danishsajjad/Headphone-Amplifier-2.0/README.md

# Headphone-Amplifier-2.0
 Attempt to create a headphone amplifier.
