danishsajjad/Headphone-Amplifier-2.0/Docs/Hand Written Design.pdf

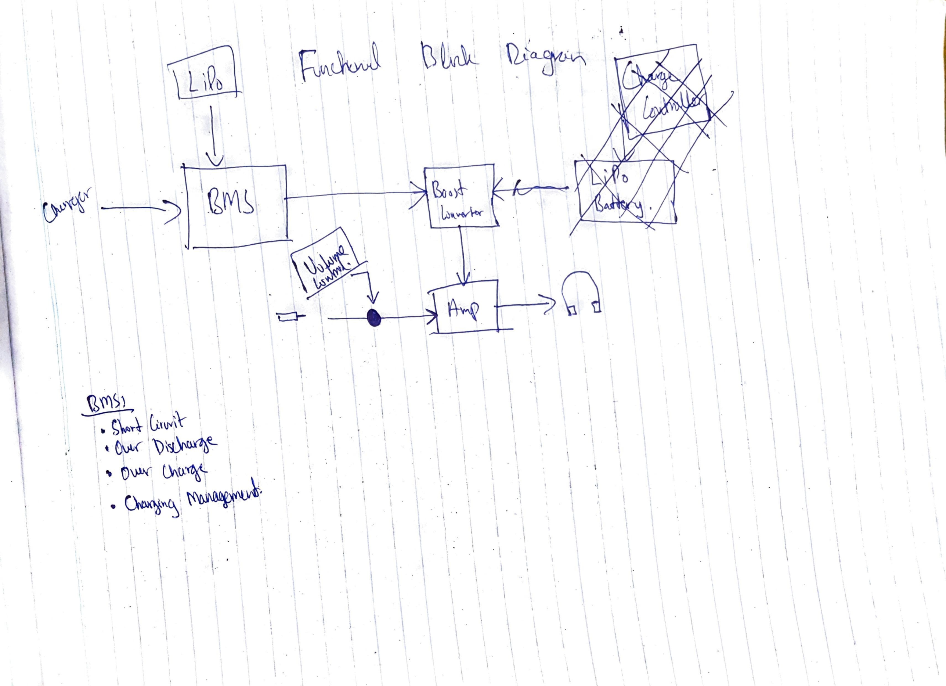
[picture p3: page 1]

# uil

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
'---

~--

~~6)~ ~~~

I.
.I

I j.
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
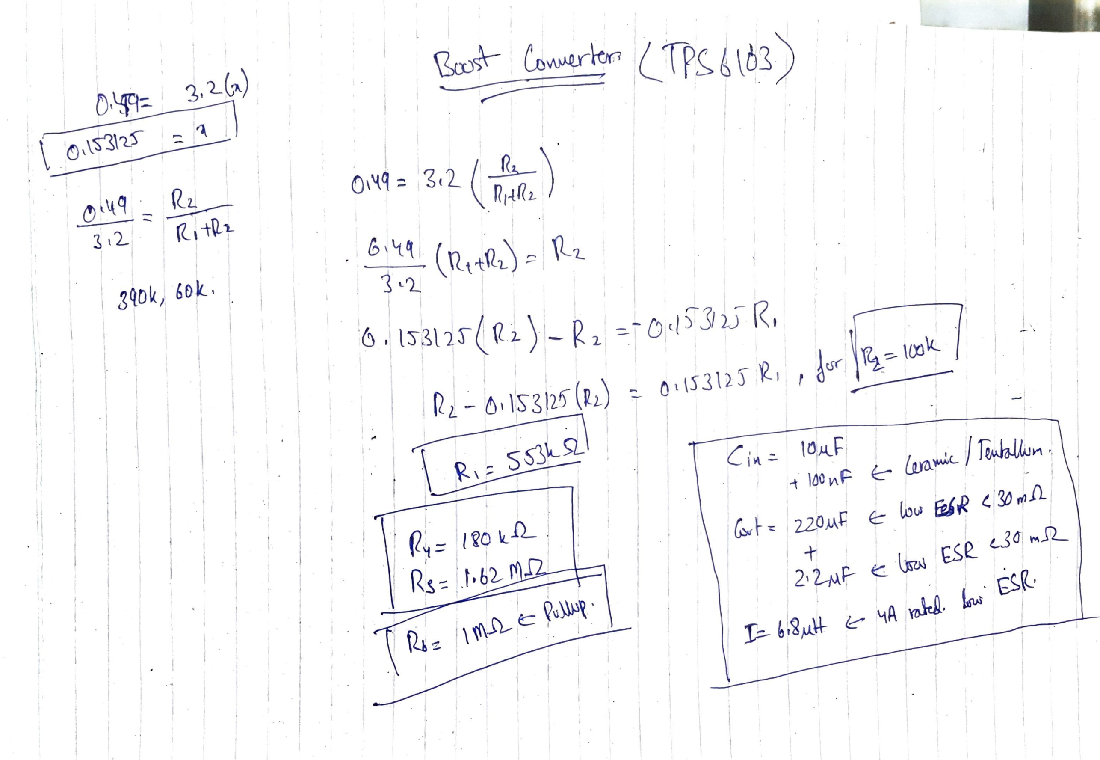
[picture p4: page 2]

## /').\fl::- 3 · '2.. C.._)

\ . C),\~\'l_-S- '.'- 'l,

I .
~ l
I
I

1,

, 3~ok1 60~. .

I I I

I ,

I I I

I

# i I . I

I •
' ' I I • • I
l I
I .
I

()11\9 :: ~( 2. / __&,._ \
\ R1-iR2- )

### . G,¼.~ , . 1 ,')__ ( ll, 1:Q,_) "I R'l_

I

## R L ~ 'tJ 1 \'s-312'f (R1-)

'
~ -

! , . I

. I

L
-=- c dS 3 \2 '.f l, r !u..-- %co- 10'.l\(__ ;--:----

·, I (, i~.::. \Cl,..u__f= I

### -1 1no "F 0 /»a .,,;,L / f ~"' . - I

### G,., ~ - 22-o )A~ e- to~ f£J R d!.o -1 A

t . ?

## 2• 4f- ('.;_ \),I>! t,St Ll gl ... SL

v- b ,\l µ_I.I- le::' "IA vJJ. I,.,,. ES~·

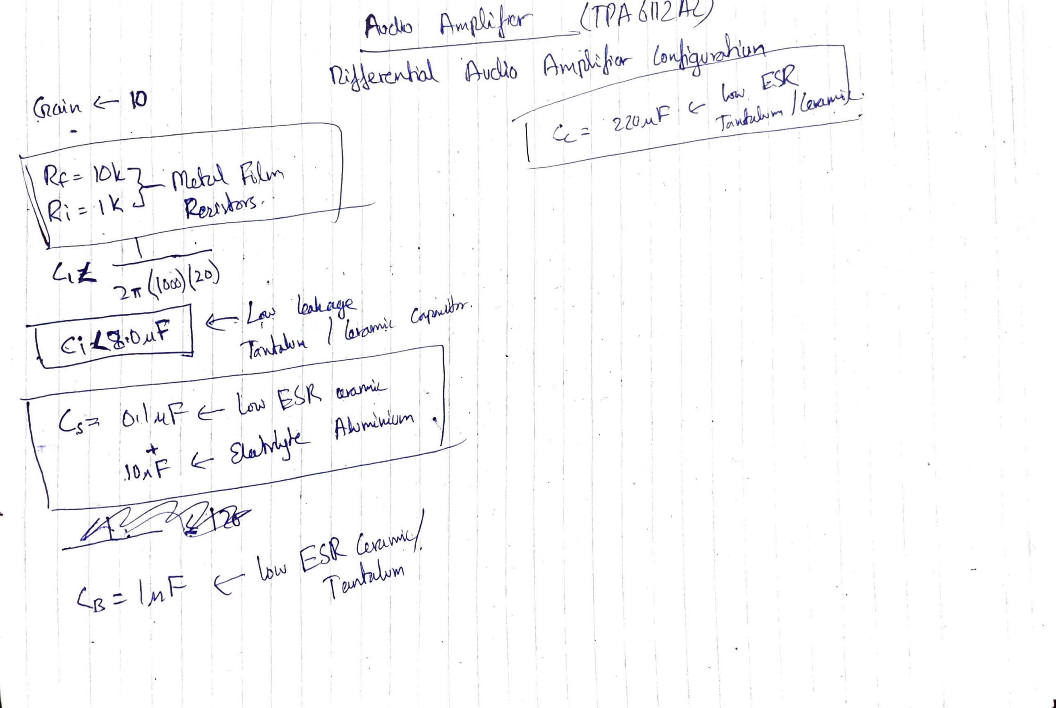
[picture p5: page 3]

I | I
.J

I •
tf\5

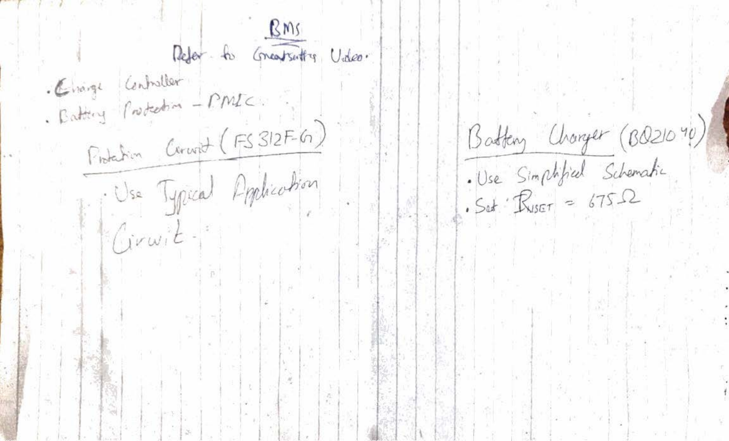
[picture p6: page 4]

••

- •
•

I

•
•

# ~ ~ ~ff't U.iki·

. l,,.,.,,( 6J~~ - r 11)1-~~ - r{Vll, c . . C •'-~' -, | .

# 0tl/fl-J-- ( F~ s12F-0) r.»,~ -

- I | 1Jf~ ynrrzt · )ia'Vl • \._,'<;.:. | ,... | l()

'

u· ~ | t v w , - · | J

I

I I
I | I
I | I | " •
| | I
- | I | I ' f

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
I | ,
1 | ~Jh (.h,~ ( (3&21o "P)

I • Use.. ~t~rJfJ ~J-~,1"0.)1 l.

•
| , SJ- · 'RisGr- -- (,7f J2.
- •

•
•

I

I

i
. I
I | •
- • •

•

•

j
