danishsajjad/Headphone-Amplifier-2.0/Docs/WhatsApp Image 2020-03-21 at 2.38.26 PM.jpeg

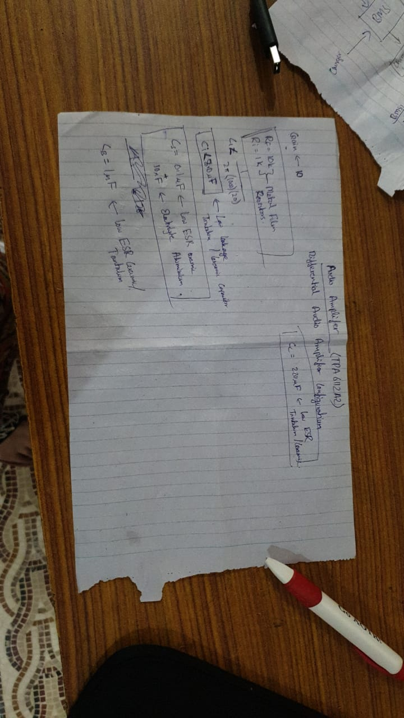
Docs/WhatsApp Image 2020-03-21 at 2.38.26 PM.jpeg
