danishsajjad/Headphone-Amplifier-2.0/Eagle Project- HA_2.0/Gerber/Board Design_2020-04-26/BOM.xlsx

Sheet: BOM
Qty | Device | Value | Package | Parts | Description
15 | LED |  | 1206 | CHARGE, L_BATT, PWR | LED
5 | ARG06DTC1000 | 100 | 1206 | R1 | RESISTOR
5 | AR06DTCV1001 | 1k | 1206 | R2 | RESISTOR
5 | AR06FTCV6800 | 680 | 1206 | R3 | RESISTOR
5 | AR06DTDV1002 | 10k | 1206 | R4 | RESISTOR
5 | TR1206D176KP0550 | 176k | 1206 | R9 | RESISTOR
15 | ARG06DTC1501 | 1.5k | 1206 | R5, R10, R19 | RESISTOR
5 | ARG06FTC1604 | 1.60M | 1206 | R8 | RESISTOR
20 | RNU18F1003A520NH | 100k |  | R13, R14, R17, R18 | RESISTOR
5 | AR06DTDV1003 | 100k | 1206 | R7 | RESISTOR
5 | TR1206D560KP0525Z | 560k | 1206 | R6 | RESISTOR
20 | RNU18F1002A520NH | 10k |  | R11, R12, R15, R16 | RESISTOR
5 | TMK316BJ106ML-T | 10u | 1206 | C5 | Ceramic/Tentalum Capacitor
5 | EEEHB1H1R0R | 1u | PANASONIC_B | C16 | Aluminium Electrolytic
5 | EEEHD1V100AR | 10u | PANASONIC_B | C17 | Aluminium Electrolytic
5 | CL31B104KBCNNNC | 100n | 1206 | C4 | Ceramic Capacitor
10 | CL31B105KAHNNNE | 1u | 1206 | C2, C3 | Ceramic
10 | CL31B104KBCNNNC | 0.1u | 1206 | C1, C20 | Ceramic
5 | CL31B225KBHNNNE | 2.2u | 1206 | C6 | Ceramic
5 | 2R5TPE220MAZB | 220u | 1206 | C7 | Tentalum
10 | 2R5TPE220MAZB | 220u | 1210 | C12, C13 | Low ESR Ceramic
20 | TCC1206COG5R0D500DT | 5p | 1206 | C14, C15, C18, C19 | Ceramic
20 | C1812X824K101T | 820n | 1812 | C8, C9, C10, C11 | LOW ESR Ceramic
5 | MS1350-6R8M | 6.8uH | SMD | L1 | High Power Density, High Efficiency, Shielded Inductors
5 | RK0971221Z05 | 10k | Through Hole | U$6 | Alps RK097 Dual Pot with Switch Part.
10 | PJ-35372 | PJ-35372 | PJ-35372 | IN, OUT | Headphone Jack
5 | 54819-0519 | MOLEX_54819 | Through Hole | U$4 | USB Power Connector
5 | BLM2012E |  | TSSOP8 | U$2
5 | BQ21040DBVR |  | SOT23-6 | U$3
5 | DTS-32K-V-B |  | Through Hole | BATT_RST | SPST Tactile Switch
5 | FS312F-G |  | SOT23-6 | U$1 | Battery Protection IC
5 | TPA6112A2DGQR |  | MSOP-10 | TPA6112A1 | Amplifier IC
5 | TPS61032PWPR |  | TSSOP16L | U$5 | Boost Converter

Sheet: Back Placement
Device | X | Y | Rot | Value | Package
C1 | 35.12 | 73.5 | 180 | 0.1u | C1206
C11 | 12.79 | 24.26 | 0 | 800n | C1812
C13 | 47.07 | 17.47 | 180 | 220u | C1210
C19 | 21.15 | 29.23 | 270 | 5p | C1206
C2 | 14.29 | 66.85 | 0 | 1u | C1206
C20 | 25.85 | 26.71 | 270 | 0.1u | C1206
C3 | 25.35 | 66.77 | 270 | 1u | C1206
R1 | 29.8 | 73.24 | 270 | 100 | M1206
R2 | 42.8 | 64.78 | 90 | 1k | M1206
R3 | 12.8 | 73.4 | 270 | 670 | M1206
R4 | 18.52 | 63.8 | 180 | 10k | M1206
R5 | 23.94 | 73.75 | 180 | 1.5k | M1206
U$1 | 34.04 | 68.15 | 0 | FS312F-G | SOT23-6
U$2 | 37.93 | 65.81 | 0 | BLM2010E | TSSOP8
U$3 | 20.15 | 67.95 | 270 | BQ21040M | SOT23-6

Sheet: Front Placement
Devicw | X | Y | Rotation | Value | Package
C10 | 25.24 | 40.94 | 270 | 800n | C1812
C12 | 42.83 | 8.39 | 270 | 220u | C1210
C14 | 30.53 | 22.15 | 180 | 5p | C1206
C15 | 17.25 | 33.61 | 270 | 5p | C1206
C16 | 46.29 | 32.47 | 180 | 1u | PANASONIC_B
C17 | 23.87 | 26.46 | 90 | 10u | PANASONIC_B
C18 | 42.69 | 28.15 | 180 | 5p | C1206
C4 | 35.5 | 70.13 | 270 | 100n | C1206
C5 | 39.45 | 67.15 | 180 | 10u | C1206
C6 | 14.73 | 64.9 | 180 | 2.2u | C1206
C7 | 14.68 | 62.1 | 180 | 220u | C1206
C8 | 33.44 | 39.14 | 270 | 800n | C1812
C9 | 36.96 | 23.61 | 90 | 800n | C1812
CHARGE | 12.41 | 2.08 | 0 |  | 1206
L1 | 36.88 | 54.88 | 180 | 6.8uH | DR127
L_BATT | 18.86 | 2.08 | 0 |  | 1206
PWR | 39.96 | 1.94 | 0 |  | 1206
R10 | 14.79 | 56.85 | 0 | 1.5k | M1206
R19 | 35.81 | 5.96 | 90 | 1.5k | M1206
R6 | 23.5 | 73.17 | 90 | 553k | M1206
R7 | 29.5 | 73.18 | 270 | 100k | M1206
R8 | 21.5 | 65.78 | 270 | 1.62M | M1206
R9 | 17.47 | 71.5 | 0 | 180k | M1206
TPA6112A1 | 27.19 | 31.09 | 90 | TPA6112A2 | MSOP-10
U$5 | 28.92 | 65.58 | 90 | TPS61032 | TSSOP16L
