danishsajjad/Headphone-Amplifier-2.0/Eagle Project- HA_2.0/Board Design.brd

## EAGLE design Eagle Project- HA_2.0/Board Design.brd (2021-04-01)

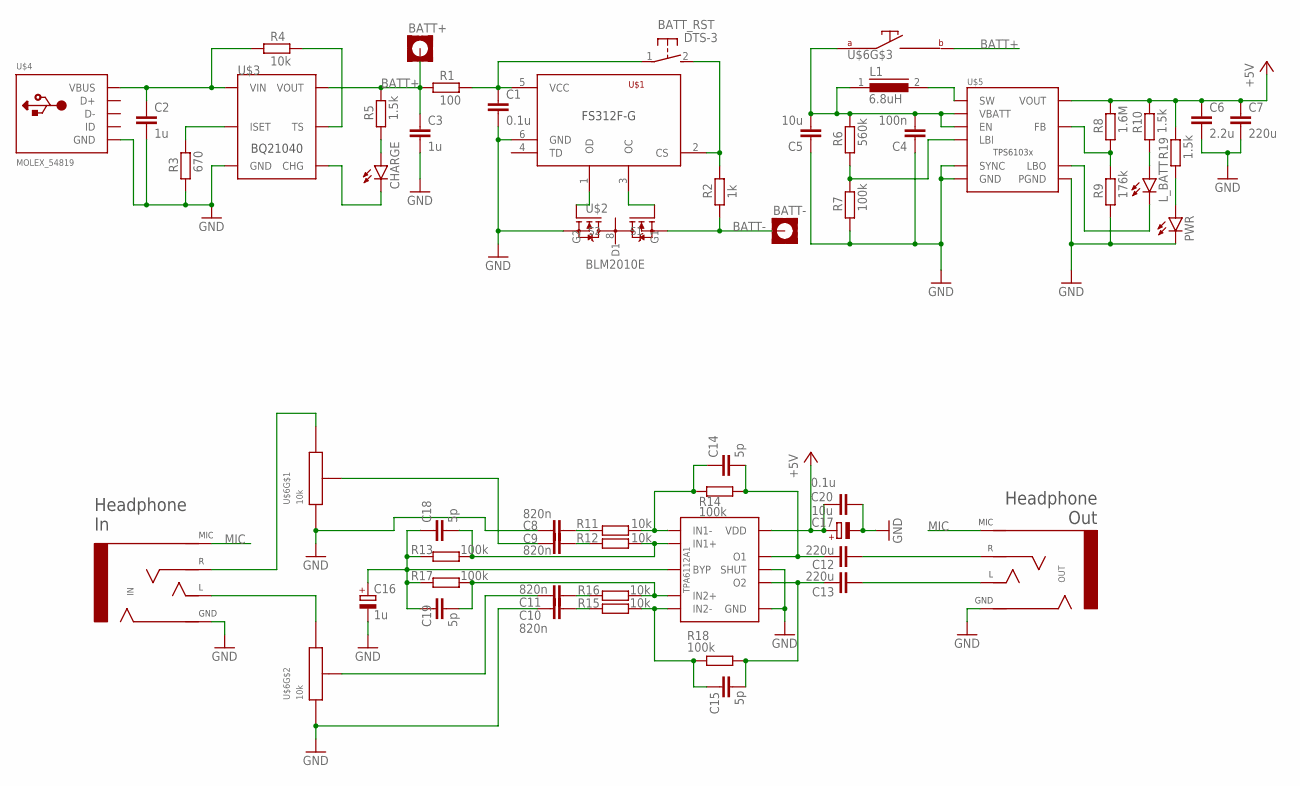
[picture p9: schematic Board Design.sch]

Parts:
BATT+: MOUNT-PAD-SQUARE2.8; 2,8-PAD-SQUARE
BATT-: MOUNT-PAD-SQUARE2.8; 2,8-PAD-SQUARE
BATT_RST: DTS-3
C1, C20: 0.1u; C1206
C2, C3: 1u; C1206
C4: 100n; C1206
C5: 10u; C1206
C6: 2.2u; C1206
C7: 220u; C1206
C8, C9, C10, C11: 820n; C1812
C12, C13: 220u; C1210
C14, C15, C18, C19: 5p; C1206
C16: 1u; PANASONIC_B
C17: 10u; PANASONIC_B
CHARGE: LEDSMT1206; 1206
IN: PJ-35372
L1: 6.8uH; DR127
L_BATT: LEDSMT1206; 1206
OUT: PJ-35372
PWR: LEDSMT1206; 1206
R1: 100; M1206
R2: 1k; M1206
R3: 670; M1206
R4: 10k; M1206
R5, R10, R19: 1.5k; M1206
R6: 560k; M1206
R7: 100k; M1206
R8: 1.6M; M1206
R9: 176k; M1206
R11, R12, R15, R16: 10k; 0204V
R13, R14, R17, R18: 100k; 0204V
TPA6112A1: TPA6112A2; MSOP-10
U$1: FS312F-G; SOT23-6
U$2: BLM2010E; TSSOP8
U$3: BQ21040M; SOT23-6
U$4: MOLEX_54819
U$5: TPS61032; TSSOP16L
U$6: 10k; RK097-DUAL-ELEMENT-W/SWITCH

Connections:
+5V: C6.1, C7.1, C17.+, C20.1, R8.2, R10.2, R19.2, TPA6112A1.10 (VDD), U$5.13 (VOUT), U$5.14 (VOUT), U$5.15 (VOUT)
BATT+: BATT+.B2,8, C3.1, R1.1, R5.2, U$3.2 (VOUT), U$6.S2
BATT-: BATT-.B2,8, R2.1, U$2.2 (S1), U$2.3 (S1)
GND: C1.2, C2.2, C3.2, C4.1, C5.1, C6.2, C7.2, C8.1, C10.1, C16.-, C17.-, C20.2, IN.2 (R2), IN.6 (R2), OUT.2 (R2), OUT.6 (R2), PWR.C, R3.1, R7.1, R9.1, TPA6112A1.5 (GND), TPA6112A1.6 (SHUT), U$1.6 (GND), U$2.6 (S2), U$2.7 (S2), U$3.5 (GND), U$4.GND, U$5.3 (PGND), U$5.4 (PGND), U$5.5 (PGND), U$5.8 (SYNC), U$5.11 (GND), U$6.1-1 (1), U$6.2-1 (1)
MIC: IN.1 (S), IN.5 (S), OUT.1 (S), OUT.5 (S)
MNVMNV: C4.2, C5.2, L1.1, R6.2, U$5.6 (VBATT), U$5.9 (EN), U$6.S1
unnamed: C2.1, R4.1, U$3.4 (VIN), U$4.VBUS
unnamed: BATT_RST.1, C1.1, R1.2, U$1.5 (VCC)
unnamed: U$1.3 (OC), U$2.4 (G1)
unnamed: U$1.1 (OD), U$2.5 (G2)
unnamed: R3.2, U$3.6 (ISET)
unnamed: BATT_RST.2, R2.2, U$1.2 (CS)
unnamed: R4.2, U$3.1 (TS)
unnamed: CHARGE.A, R5.1
unnamed: CHARGE.C, U$3.3 (CHG)
unnamed: L1.2, U$5.1 (SW), U$5.2 (SW)
unnamed: L_BATT.C, U$5.10 (LBO)
unnamed: L_BATT.A, R10.1
unnamed: C16.+, C18.1, C19.1, R13.1, R17.1, TPA6112A1.4 (BYP)
unnamed: R8.1, R9.2, U$5.12 (FB)
unnamed: PWR.A, R19.1
unnamed: C12.1, C14.2, R14.2, TPA6112A1.1 (O1)
unnamed: R6.1, R7.2, U$5.7 (LBI)
unnamed: C13.1, C15.2, R18.2, TPA6112A1.9 (O2)
unnamed: C8.2, R11.1
unnamed: C9.2, R12.1
unnamed: C18.2, R12.2, R13.2, TPA6112A1.3 (IN1+)
unnamed: C14.1, R11.2, R14.1, TPA6112A1.2 (IN1-)
unnamed: C11.1, U$6.2-3 (3)
unnamed: C19.2, R16.2, R17.2, TPA6112A1.7 (IN2+)
unnamed: C11.2, R16.1
unnamed: C10.2, R15.1
unnamed: C15.1, R15.2, R18.1, TPA6112A1.8 (IN2-)
unnamed: C9.1, U$6.1-3 (3)
unnamed: IN.4 (T), IN.8 (T), U$6.2-2 (2)
unnamed: IN.3 (R1), IN.7 (R1), U$6.1-2 (2)
unnamed: C13.2, OUT.4 (T), OUT.8 (T)
unnamed: C12.2, OUT.3 (R1), OUT.7 (R1)

Notes on the sheet:
Headphone In
Headphone Out

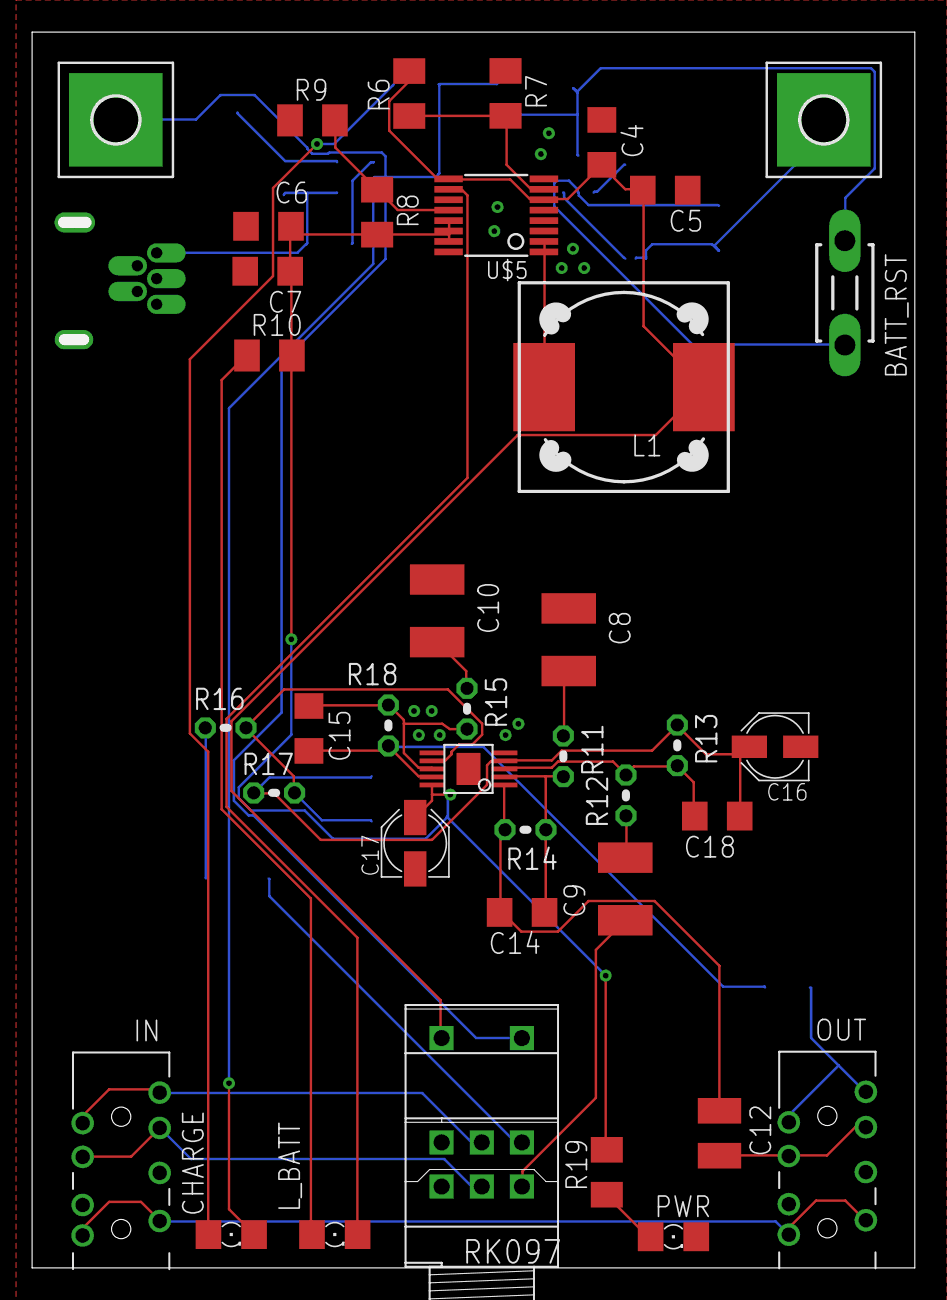
[picture p10: board Board Design.brd from above]

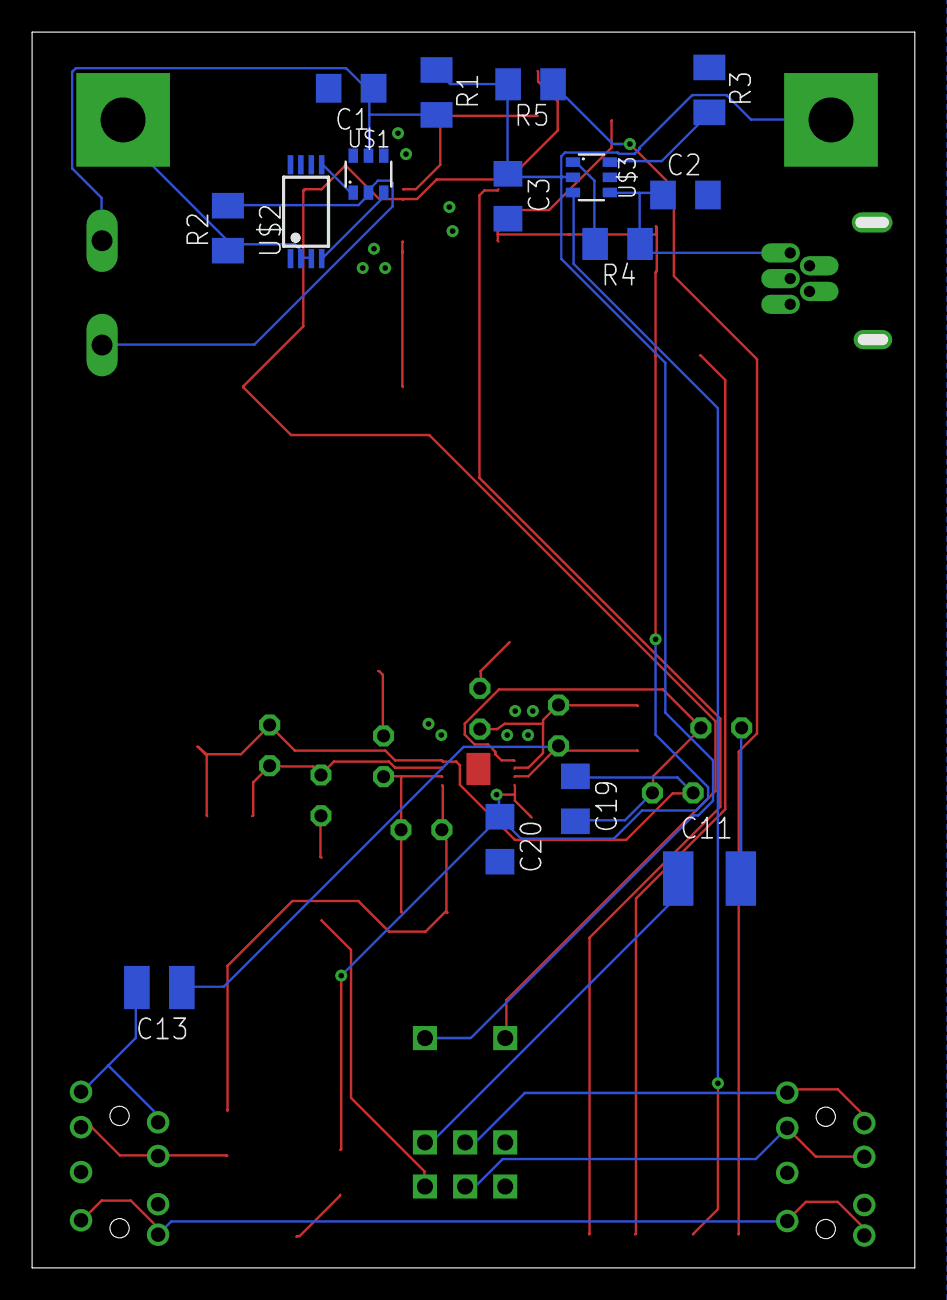
[picture p11: board Board Design.brd from below]

Board: 2 copper layers, 55.0 x 77.0 mm, 55 parts (15 on the bottom side), 38 nets.
